git-tests/benchmarks/circuit_board/Cadence/pc042a_lib/pc042b_toplevel/images/fmc_vita57.jpg

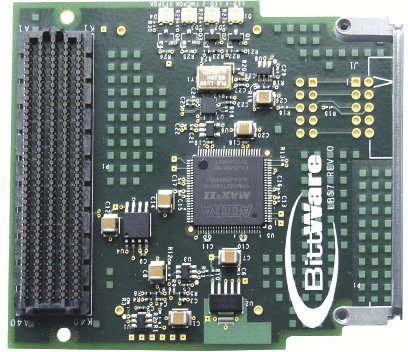
circuit_board/Cadence/pc042a_lib/pc042b_toplevel/images/fmc_vita57.jpg
