git-tests/benchmarks/circuit_board/README

AIDA mini-TLU

Double-height FMC with single FMC-LPC connector

Designed in using the Cadence 16.3 package licenced through Europractice.

Uses the CERN component libraries.
