git-tests/benchmarks/circuit_board/Cadence/pc042a_lib/pc036a_fmc_lpc_connector/metadata/pinlist.txt

(Pinlist
	(Pin
		(Name IIC_SDA_MAIN)
		(MSB )
		(LSB )
		(Type UNSPEC)
		(Location Top)
		(InputLoadLow )
		(InputLoadHigh )
		(OutputLoadLow )
		(OutputLoadHigh )
		(CheckLoad Off)
		(CheckIO Off)
		(CheckDir 0)
		(CheckAssert 0)
		(CheckOutput 0)
		(UnknownLoading 0)
		(PinShape Line)
		(DIFF_PAIR_PINS_POS )
		(DIFF_PAIR_PINS_NEG )
	)

	(Pin
		(Name FMC_LA*)
		(MSB 33)
		(LSB 0)
		(Type UNSPEC)
		(Location Top)
		(InputLoadLow )
		(InputLoadHigh )
		(OutputLoadLow )
		(OutputLoadHigh )
		(CheckLoad Off)
		(CheckIO Off)
		(CheckDir 0)
		(CheckAssert 0)
		(CheckOutput 0)
		(UnknownLoading 0)
		(PinShape Dot)
		(DIFF_PAIR_PINS_POS )
		(DIFF_PAIR_PINS_NEG )
	)

	(Pin
		(Name FMC_LA)
		(MSB 33)
		(LSB 0)
		(Type UNSPEC)
		(Location Top)
		(InputLoadLow )
		(InputLoadHigh )
		(OutputLoadLow )
		(OutputLoadHigh )
		(CheckLoad Off)
		(CheckIO Off)
		(CheckDir 0)
		(CheckAssert 0)
		(CheckOutput 0)
		(UnknownLoading 0)
		(PinShape Line)
		(DIFF_PAIR_PINS_POS )
		(DIFF_PAIR_PINS_NEG )
	)

	(Pin
		(Name FMC_CLK1_M2C_P)
		(MSB )
		(LSB )
		(Type UNSPEC)
		(Location Top)
		(InputLoadLow )
		(InputLoadHigh )
		(OutputLoadLow )
		(OutputLoadHigh )
		(CheckLoad Off)
		(CheckIO Off)
		(CheckDir 0)
		(CheckAssert 0)
		(CheckOutput 0)
		(UnknownLoading 0)
		(PinShape Line)
		(DIFF_PAIR_PINS_POS )
		(DIFF_PAIR_PINS_NEG )
	)

	(Pin
		(Name FMC_CLK1_M2C*)
		(MSB )
		(LSB )
		(Type UNSPEC)
		(Location Top)
		(InputLoadLow )
		(InputLoadHigh )
		(OutputLoadLow )
		(OutputLoadHigh )
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
		(LSB )
		(Type UNSPEC)
		(Location Left)
		(InputLoadLow )
		(InputLoadHigh )
		(OutputLoadLow )
		(OutputLoadHigh )
		(CheckLoad Off)
		(CheckIO Off)
		(CheckDir 0)
		(CheckAssert 0)
		(CheckOutput 0)
		(UnknownLoading 0)
		(PinShape Line)
		(DIFF_PAIR_PINS_POS )
		(DIFF_PAIR_PINS_NEG )
	)

	(Pin
		(Name FPGA_TCK_BUF)
		(MSB )
		(LSB )
		(Type UNSPEC)
		(Location Left)
		(InputLoadLow )
		(InputLoadHigh )
		(OutputLoadLow )
		(OutputLoadHigh )
		(CheckLoad Off)
		(CheckIO Off)
		(CheckDir 0)
		(CheckAssert 0)
		(CheckOutput 0)
		(UnknownLoading 0)
		(PinShape Line)
		(DIFF_PAIR_PINS_POS )
		(DIFF_PAIR_PINS_NEG )
	)

)
