git-tests/benchmarks/circuit_board/Cadence/pc042a_lib/pc042a_toplevel/physical/pc042a_09.jpg

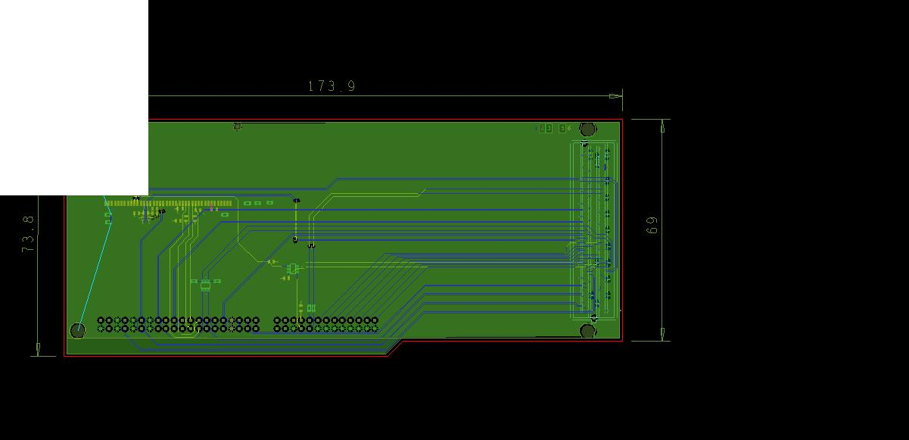
circuit_board/Cadence/pc042a_lib/pc042a_toplevel/physical/pc042a_09.jpg
