git-tests/benchmarks/circuit_board/Cadence/pc042a_lib/pc042b_vsupply5v/physical/3d.jpg

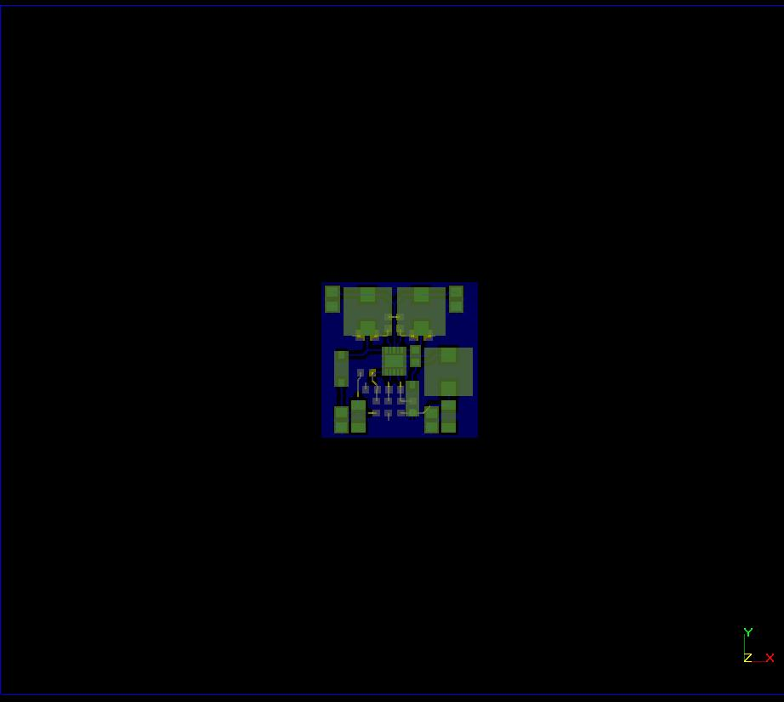
circuit_board/Cadence/pc042a_lib/pc042b_vsupply5v/physical/3d.jpg
