git-tests/benchmarks/firmware/hdl_designer/fmc_mTLU/www/images/menu/hds/hdldesigner.gif

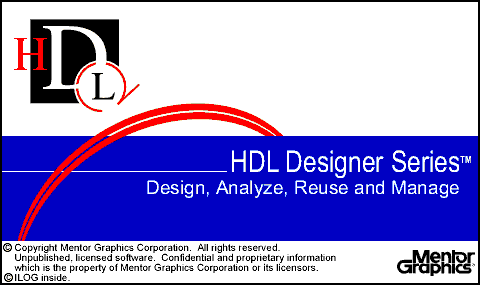
firmware/hdl_designer/fmc_mTLU/www/images/menu/hds/hdldesigner.gif
