git-tests/benchmarks/circuit_board/Cadence/worklib/fmc_tlu_toplevel/bom/fmc_mtlu.xls

TITLE: Bill of Materials
DATE: 11/01/2012
DESIGN: fmc_tlu_toplevel
TEMPLATE: G | \cad\tools\cadence_templates\spreadsheet-format.bom
CALLOUT: bom.callouts
Part Name | Ref Des | Qty | PART_NUMBER | PART_DESCRIPTION | distributor part no. | unit cost | total cost
24AA025E48 | IC7 | 1 | 24AA025E48 |  | Farnell 1814890 | £0.27 | £0.27
AD5665RBRUZ-1 | IC1 | 1 | AD5665RBRUZ-1 |  | Farnell 1498714 | £13.95 | £13.95
ASP-134606-01 | J4 | 1 | ASP-134606-01 | Samtec FMC connector. Order from Samtec | ? | 0 | £0.00
CAPCERSMDCL1_0603-33PF,50V | C6_5 | 1 | CC0603_33PF_50V_5%_NP0 |  | Farnell 1414633 | £0.02 | £0.02
CAPCERSMDCL1_0603-68PF,50V | C9_5 | 1 | CC0603_68PF_50V_5%_NP0 |  | Farnell 1414647 | £0.03 | £0.03
CAPCERSMDCL2_0603-1.0UF,6.3V | C3_1,C3_2,C3_3,C3_4,C4_1,C4_2,C4_3,C4_4,C6_1,C6_2,C6_3,C6_4 | 12 | CC0603_1UF_6V3_10%_X5R |  | Farnell 1327676 | £0.08 | £1.01
CAPCERSMDCL2_0603-100NF,16V | C1,C1_1,C1_2,C1_3,C1_4,C4,C4_5,C5,C5_1,C5_2,C5_3,C5_4,C7,C7_1,C7_2,C7_3,C7_4,C8,C8_1,C8_2,C8_3,C8_4,C9,C9_1,C9_2,C9_3,C9_4,C10,C10_1,C10_2,C10_3,C10_4,C11,C12,C13,C14,C15,C16,C17 | 39 | CC0603_100NF_16V_10%_X7R | ? | Farnell 1301716 | £0.09 | £3.39
CAPCERSMDCL2_0603-10NF,50V | C2_1,C2_2,C2_3,C2_4 | 4 | CC0603_10NF_50V_10%_X7R | ? | Farnell 7569548 | £0.09 | £0.36
CAPCERSMDCL2_0603-1UF,16V | C2,C3,C5_5,C6 | 4 | CC0603_1UF_16V_10%_X5R | ? | Farnell 1327680 | £0.07 | £0.30
CAPCERSMDCL2_0805-10UF,10V_GEN | C7_5 | 1 | CC0805_10UF_10V_10%_X5R | ? | Farnell 1833812 | £0.08 | £0.08
CAPCERSMDCL2_0805-330NF,50V | C2_5,C3_5 | 2 | CC0805_330NF_50V_10%_X7R | ? | Farnell 2070476 | £0.09 | £0.19
CAPCERSMDCL2_0805-4.7UF,10V | C1_5,C8_5,C10_5,C11_5,C12_5,C13_5,C14_5,C15_5 | 8 | GRM21BF51A475ZA01 | ? | Farnell 1828924 | £0.15 | £1.19
CON8P-MOLEX_44661-1011 | J3 | 1 | 44661-1011 | ? | Digikey 0446611011-ND | £3.40 | £3.40
DIODE_SCHOTTKY_CA-SD101AW | D1_5,D2_5 | 2 | SD101AW | ? | Farnell 1773493 | 0.38 | £0.76
FERRITE_SMD-7427921,WURTH | L4_5,L5_5 | 2 | 7427921 | ? | Farnell 1635739 | £0.20 | £0.40
FERRITE_SMD-BLM41P800S,MURATA | L6_5 | 1 | 08.11.BLM41P800S | ? | Digikey 490-1059-1-ND | 0.028 | £0.03
GL2L5LS050D-C | IC1_1,IC1_2,IC1_3,IC1_4 | 4 | GL2L5LS050D-C | DELAY LINE 0.5NS +-50PS 16SOIC | Digikey 408-1139-ND | 15.69 | £62.76 | Bother – expensive and difficult to get hold of
GL2L5LS100D-C | IC3_1,IC3_2,IC3_3,IC3_4 | 4 | GL2L5LS100D-C | DELAY LINE 1.0NS +-50PS 16SOIC | Digikey 408-1140-ND | 15.69 | £62.76 | expensive and difficult to get hold of.
HBAT-540C | D1_1,D1_2,D1_3,D1_4 | 4 | HBAT-540C | Schottky diode clamp | RS 752-7852 | 0.044 | £0.18 | Substitute BAT 64-04 for HBAT-540C
INDUCTANCE_XS-10UH_25% | L1_5,L2_5,L3_5 | 3 | 744778510 | ? | Farnell 1635961 | £1.65 | £4.95
LT1129CST-5_SOT223-LINEAR | VR1_5 | 1 | Linear Technology LT1129CST-5 | 700mA, 5V LDO Regulator | Farnell 1663375 | £3.38 | £3.38
LT1175_SOT_223 | REG1_5 | 1 | Farnell | 500mA Negative low dropout Micropower Regulator | Farnell 1663390 | £3.88 | £3.88
LT3471EDD#PBF | IC1_5 | 1 | LT3471EDD#PBF | ? | Farnell 1663557 | £5.09 | £5.09
MAX9601_TSSOP | IC2_1,IC2_2,IC2_3,IC2_4 | 4 | MAX9601EUP | ? | Farnell 1610136 | £10.19 | £40.76
MHDMI-19-02-H-TH-L-TR | J1,J2 | 2 | MHDMI-19-02-H-TH-L-TR | ? | RS 720-6003 | £0.92 | £1.84
OPA4277UA | IC2 | 1 | OPA4277UA | ? | Farnell 1097479 | £8.14 | £8.14
PCOAX-PLEMO00C | PX2,PX3,PX4,PX5 | 4 | EPL.00.250.NTN | ? | farnel/cpc CN08069 | £7.56 | £30.24
PLEMO2CI-PLEMO2-00B | PX1 | 1 | EPG.00.302.NLN | ? | RS 204-8824 | £31.18 | £31.18
PRTR5V0U8S_TSSOP-NXP | U1,U2,U3 | 3 | PRTR5V0U8S | ESD Protection Diodes 5.5V Octal TSSOP10 | RS 725-8739 , Farnell 1757871 | £0.69 | £2.07
RSMD0402_1/16W-51,1% | R1_1,R1_2,R1_3,R1_4,R4_1,R4_2,R4_3,R4_4 | 8 | R0402_51R_1%_0.063W_200PPM | ? | Farnell 1458803 | £0.06 | £0.51
RSMD0603_-00, | R18,R20,R22 | 3 | R0603_00_JUMPER | ? | Farnell 9233130 | £0.06 | £0.18
RSMD0603_1/10W-100,1% | R5_1,R5_2,R5_3,R5_4,R7_1,R7_2,R7_3,R7_4 | 8 | R0603_100R_1%_0.1W_100PPM | ? | Farnell 2008332 | £0.01 | £0.12
RSMD0603_1/10W-10K,1% | R1,R2,R3,R4,R5,R6,R7,R8 | 8 | R0603_10K_1%_0.1W_100PPM | ? | Farnell 2008341 | £0.01 | £0.12
RSMD0603_1/10W-1K,1% | R15,R16 | 2 | R0603_1K_1%_0.1W_100PPM | ? | Farnell 1688459 | £0.88 | £1.76
RSMD0603_1/10W-33K,1% | R9_1,R9_2,R9_3,R9_4 | 4 | R0603_33K_1%_0.1W_100PPM | ? | Farnell 2008364 | £0.01 | £0.04
RSMD0603_1/10W-51,1% | R3_1,R3_2,R3_3,R3_4,R9,R10,R11,R12,R13,R14 | 10 | R0603_51R_1%_0.1W_100PPM | ? | Farnell 2059275 | £0.01 | £0.09
RSMD0603_1/10W-75,1% | R11_1,R11_2,R11_3,R11_4,R12_1,R12_2,R12_3,R12_4,R13_1,R13_2,R13_3,R13_4,R14_1,R14_2,R14_3,R14_4 | 16 | R0603_75R_1%_0.1W_100PPM | ? | Farnell 2059282 | £0.01 | £0.14
RSMD0603_1/10W-XX,1% | R10_1,R10_2,R10_3,R10_4,R17,R19,R21 | 7 | R0603_XX_1%_0.1W_100PPM | ? | not fitted | 0 | £0.00
RSMD0603_1/16W-20K,1% | R3_5,R6_5 | 2 | R0603_20K_1%_0.063W_100PPM | ? | Farnell 2059432 | £0.01 | £0.02
RSMD0603_1/16W-4.7K,5% | R1_5,R2_5 | 2 | R0603_4K7_5%_0.063W_100PPM | ? | Farnell 1632579 | £0.02 | £0.05
RSMD0603_1/16W-90.9K,1% | R5_5 | 1 | R0603_90K9_1%_0.063W_100PPM | ? | Farnell 2059492 | £0.01 | £0.01
RSMD0603_100MW-110K,0.1% | R4_5 | 1 | R0603_110K_0.1%_0.100W_100PPM | ? | Farnell 2059495 | £0.01 | £0.01
RSMD0805_125MW-100,1% | R6_1,R6_2,R6_3,R6_4,R8_1,R8_2,R8_3,R8_4 | 8 | R0805_100R_1%_0.125W_100PPM | ? | Farnell 1469862 | £0.01 | £0.11
RSMD0805_125MW-12,1% | R2_1,R2_2,R2_3,R2_4 | 4 | R0805_12R_1%_0.125W_100PPM | ? | Farnell 1260836 | £0.01 | £0.04
SN74LVC1G07DCK | IC4,IC6 | 2 | SN74LVC1G07DCK | ? | Farnell 1236609 | £0.28 | £0.56
TRANS MOSFET_GSD-FDV301N,SOT23 | T1,T2 | 2 | FDV301N | ? | farnel/cpc SC11006 | £0.07 | £0.14
USBLC6-2SC6 | IC3,IC5 | 2 | USBLC6-2SC6 | ? | Farnell 1269406 | £0.53 | £1.06
TOTAL |  | 204
Different types of component |  | 47 |  |  |  | Grand total | £287.56
 | Note:- resistors are bought in packs of fifty so the price will be slightly higher |  |  |  |  | Grand total (no delay lines) | £162.05
