git-tests/benchmarks/circuit_board/Manufacturing/checklists/fmc_tlu_toplevel_v1_schematic_checklist.xls

Item | Comments | Result | Checked by | Date checked
IC7 connected correctly? | Not that important – only present to allow each board to have a unique ID
J1,J2,J3 connected correctly? | ESSENTIAL: J3 should be like EUDET TLU, J1,J2 should be compatible with CALICE C&C board https://twiki.cern.ch/twiki/pub/CALICE/ClockControlCard/CCC_sch_1aa_2008-08-29.pdf
IC3, U1 etc. Connected correctly? | Protection diodes. Could be omitted if pinout incorrect
IC4, T1 etc. Connected correctly | Switchable power on HDMI for HDMI-->Lemo converter boards. Could be patched if required
J4 connected correctly? | Very important – but already checked pretty thoroughly
IC1 connected correctly? | Very important – could hack board to apply biases from external supply, but pretty nasty
IC2 connected correctly? | Very important – but believed correct
IC2_1 ... IC2_4 connected correctly? | ESSENTIAL: this circuit is simple, but hasn't been constructed by me before.
IC1_5 , VR1_5 , REG1_5 connected correctly? | VERY IMPORTANT – could hack board to supply +/-5V externally, but pretty nasty
LT3471 , MAX9601 footprints correct? | Not used before
