git-tests/benchmarks/circuit_board/Schematics/fmc_tlu_cfd.pdf

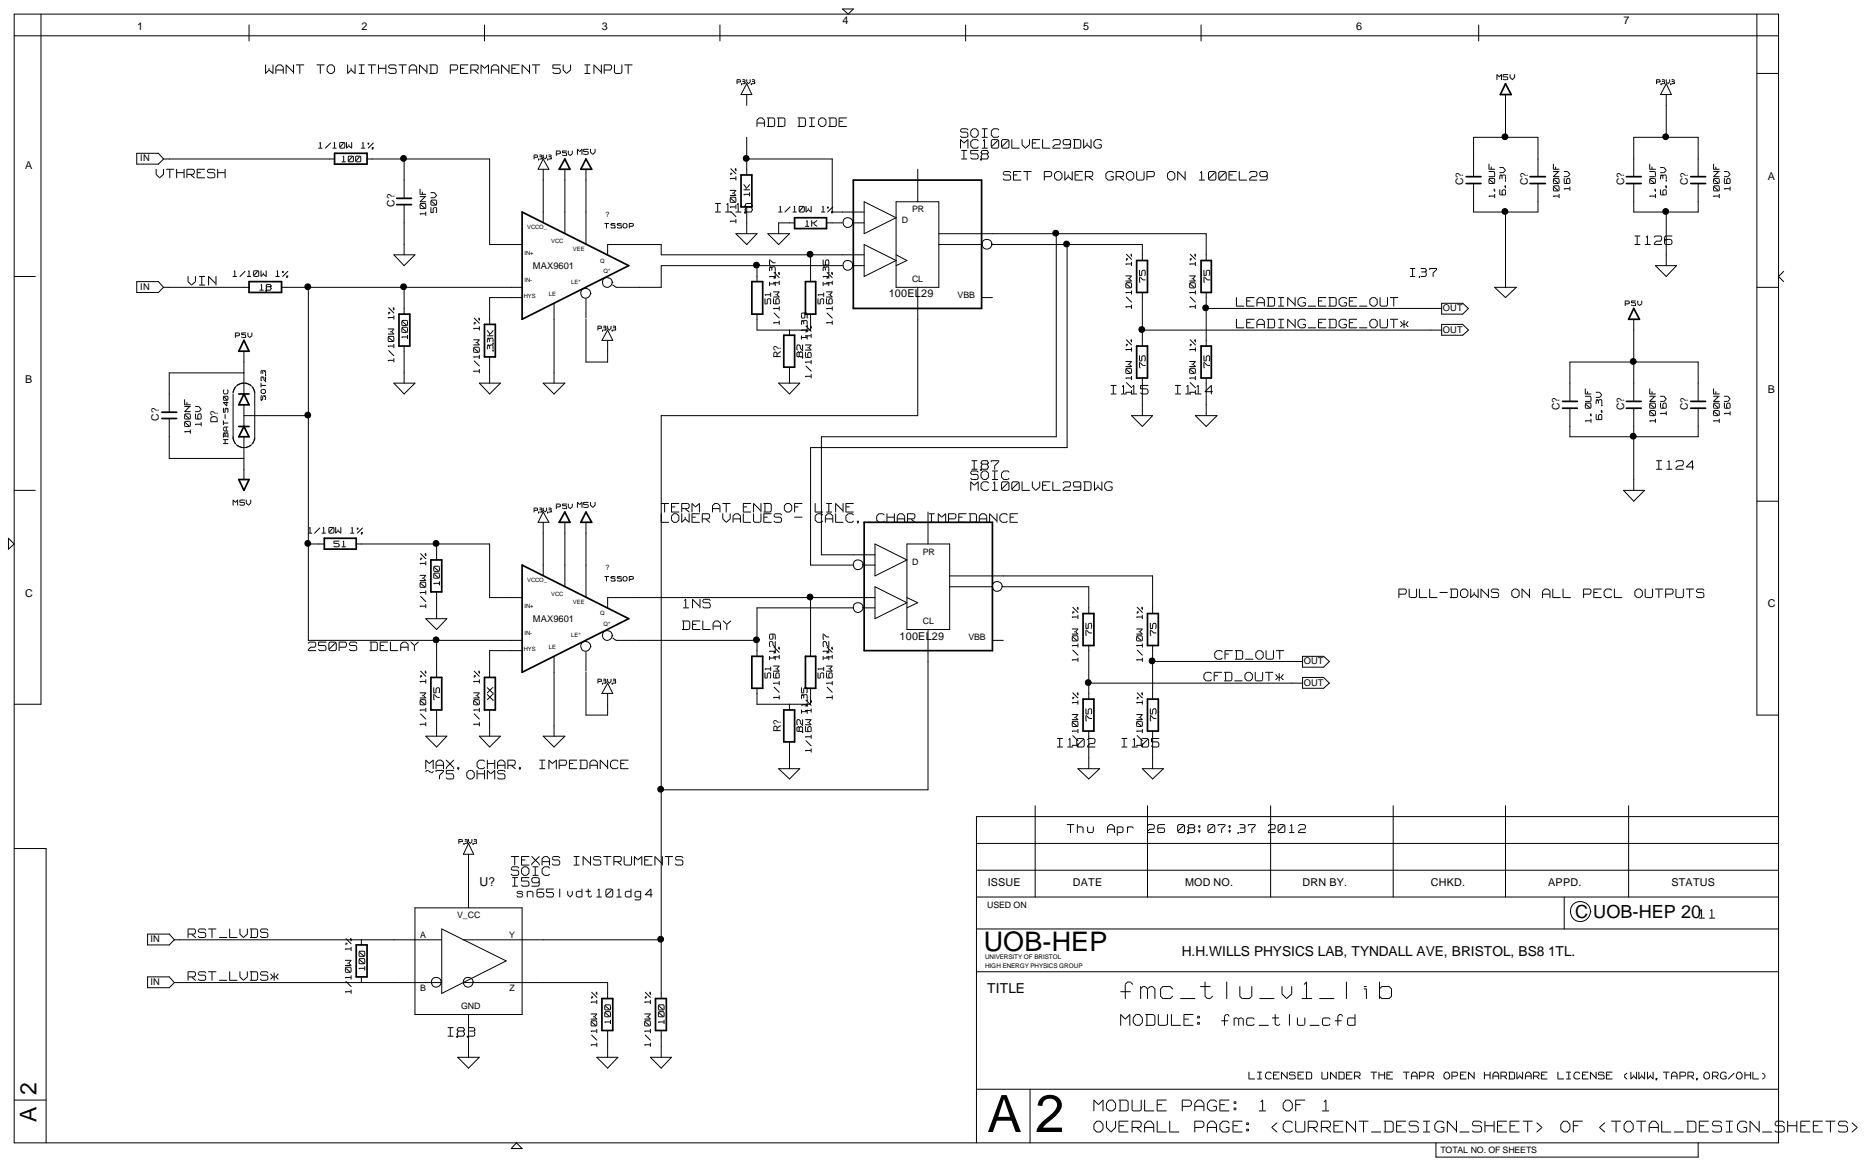
[picture p7: page 1]
DELAY; ADD DIODE; 250PS DELAY; LOWER VALUES - CALC. CHAR; IMPEDANCE; MODULE; PAGE: 1 OF 1; OVERALL; PAGE: <CURRENT_DESIGN_SHEET>; OF <TOTAL_DESIGN_SHEETS>; Thu Apr 26 08:07:37 2012; I87 MC100LVEL29DWG SOIC; TSSOP; LEADING_EDGE_OUT*; LEADING_EDGE_OUT; RST_LVDS*; sn65lvdt101dg4; I59 SOIC; RST_LVDS; TEXAS INSTRUMENTS; SOT23; HBAT-540C; CFD_OUT*; 1/10W CFD_OUT; 1% VIN; VTHRESH; VCCO_; VEE; VCC; HYS; VBB; GND; MAX9601; OUT; UOB-HEP

WANT TO WITHSTAND PERMANENT 5V INPUT

SOIC
I58 MC100LVEL29DWG
SET POWER GROUP ON 100EL29

TERM AT END OF LINE

PULL-DOWNS ON ALL PECL OUTPUTS

~75 OHMS MAX. CHAR. IMPEDANCE

ISSUE | DATE | MOD NO. | DRN BY. | CHKD. | APPD. | STATUS
USED ON | C UOB-HEP 20 11

UNIVERSITY OF BRISTOL
HIGH ENERGY PHYSICS GROUP
TITLE

H.H.WILLS PHYSICS LAB, TYNDALL AVE, BRISTOL, BS8 1TL.
fmc_tlu_v1_lib
MODULE: fmc_tlu_cfd

LICENSED UNDER THE TAPR OPEN HARDWARE LICENSE (WWW.TAPR.ORG/OHL)

TOTAL NO. OF SHEETS
