git-tests/benchmarks/circuit_board/Schematics/fmc_tlu_v1.pdf

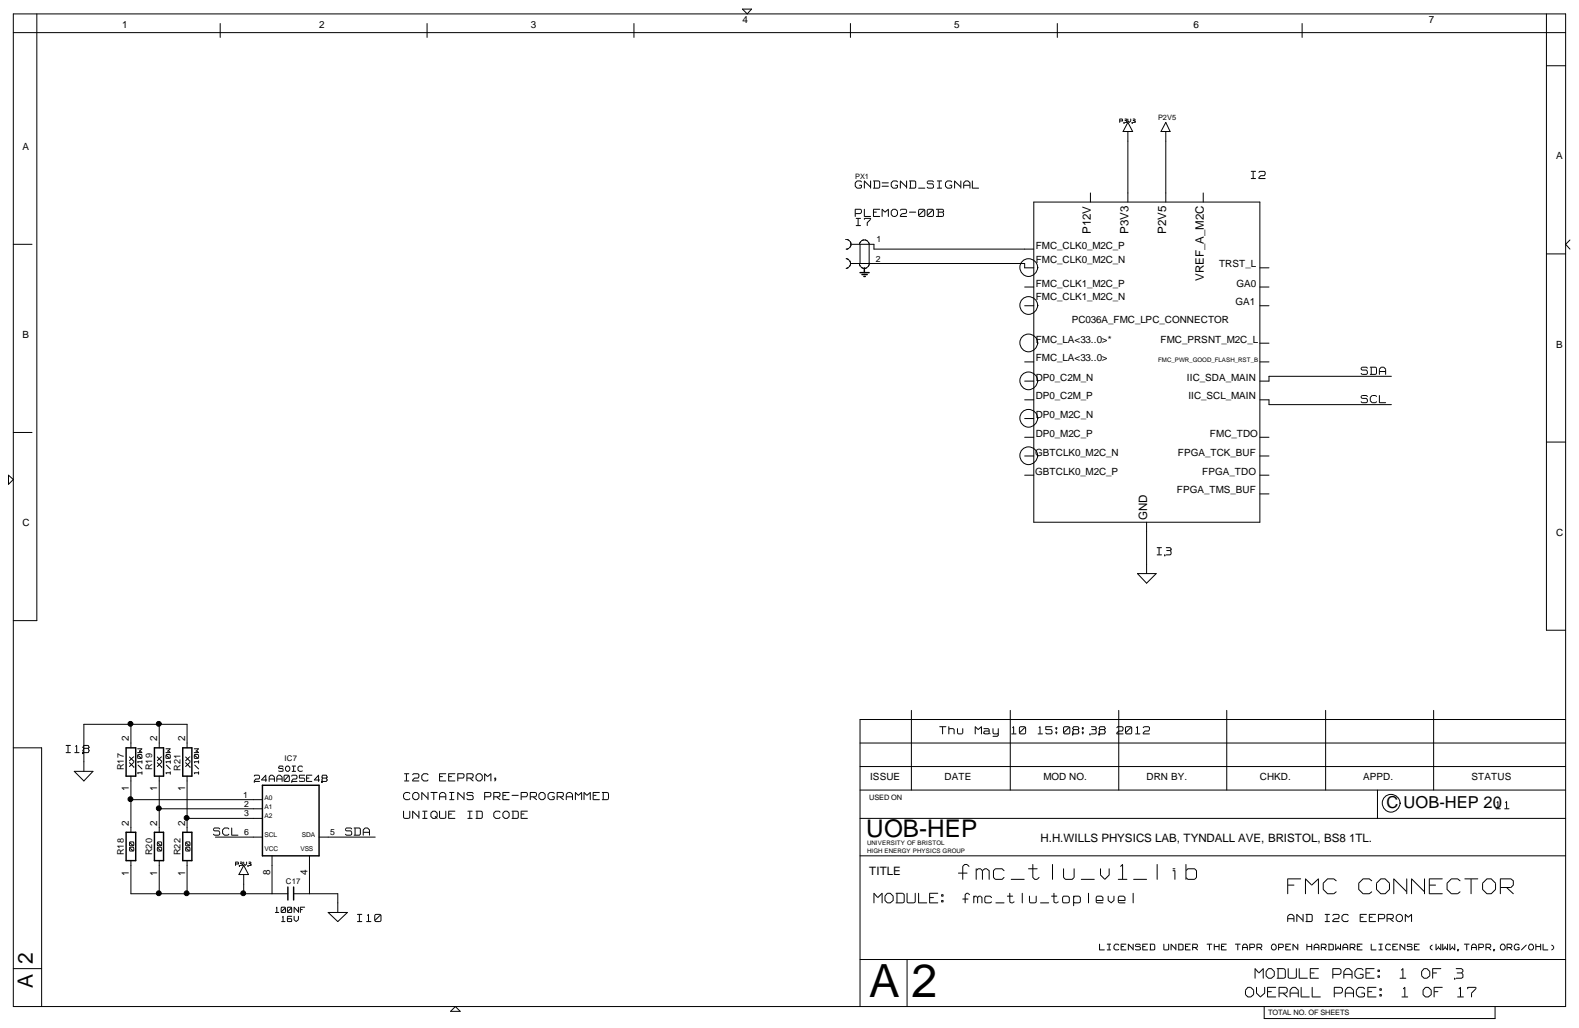
[picture p8: page 1]

UNIVERSITY OF BRISTOL
HIGH ENERGY PHYSICS GROUP

H.H.WILLS PHYSICS LAB, TYNDALL AVE, BRISTOL, BS8 1TL.

LICENSED UNDER THE TAPR OPEN HARDWARE LICENSE (WWW.TAPR.ORG/OHL)

TOTAL NO. OF SHEETS

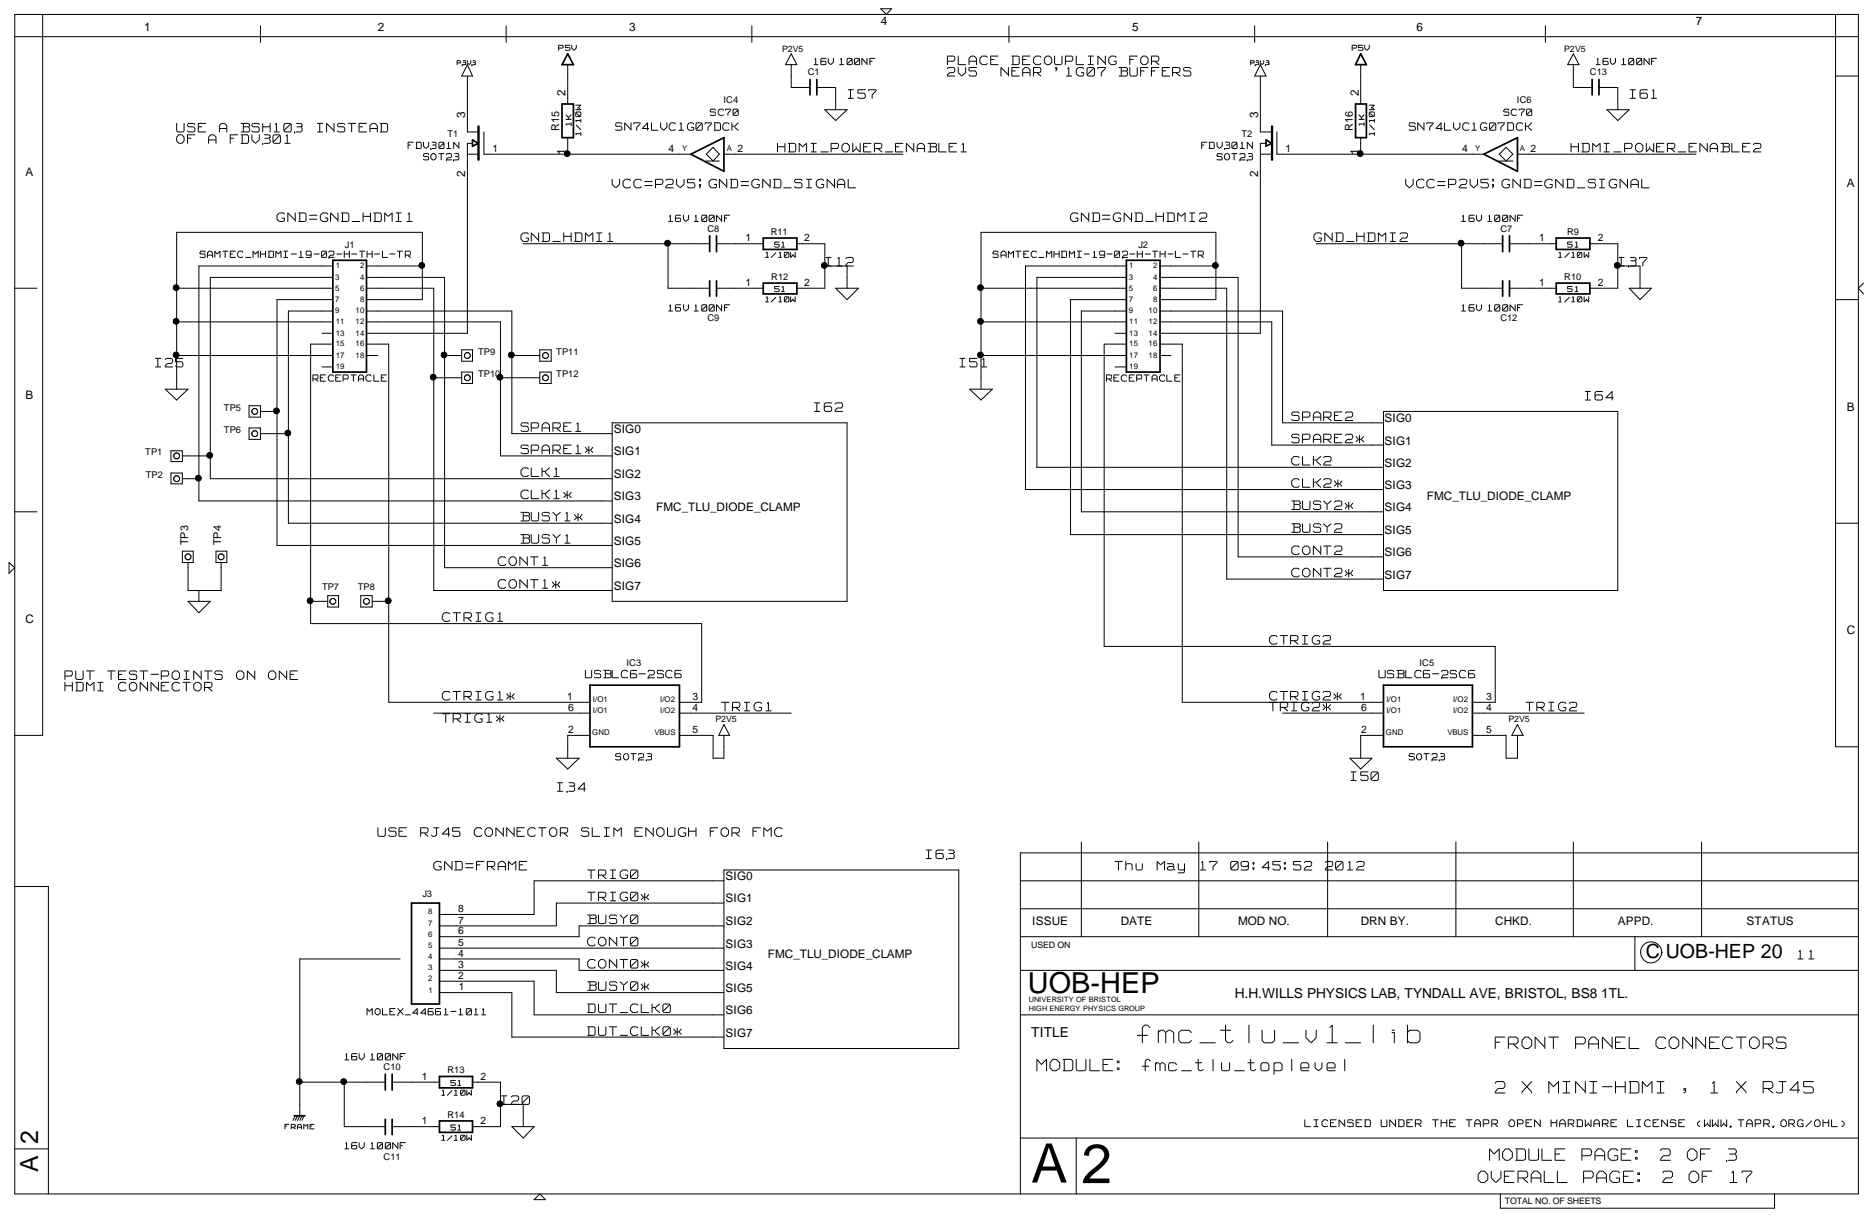
[picture p9: page 2]

PUT TEST-POINTS ON ONE
HDMI CONNECTOR

USE RJ45 CONNECTOR SLIM ENOUGH FOR FMC

UNIVERSITY OF BRISTOL
HIGH ENERGY PHYSICS GROUP
TITLE
MODULE: fmc_tlu_toplevel

H.H.WILLS PHYSICS LAB, TYNDALL AVE, BRISTOL, BS8 1TL.

LICENSED UNDER THE TAPR OPEN HARDWARE LICENSE (WWW.TAPR.ORG/OHL)

TOTAL NO. OF SHEETS

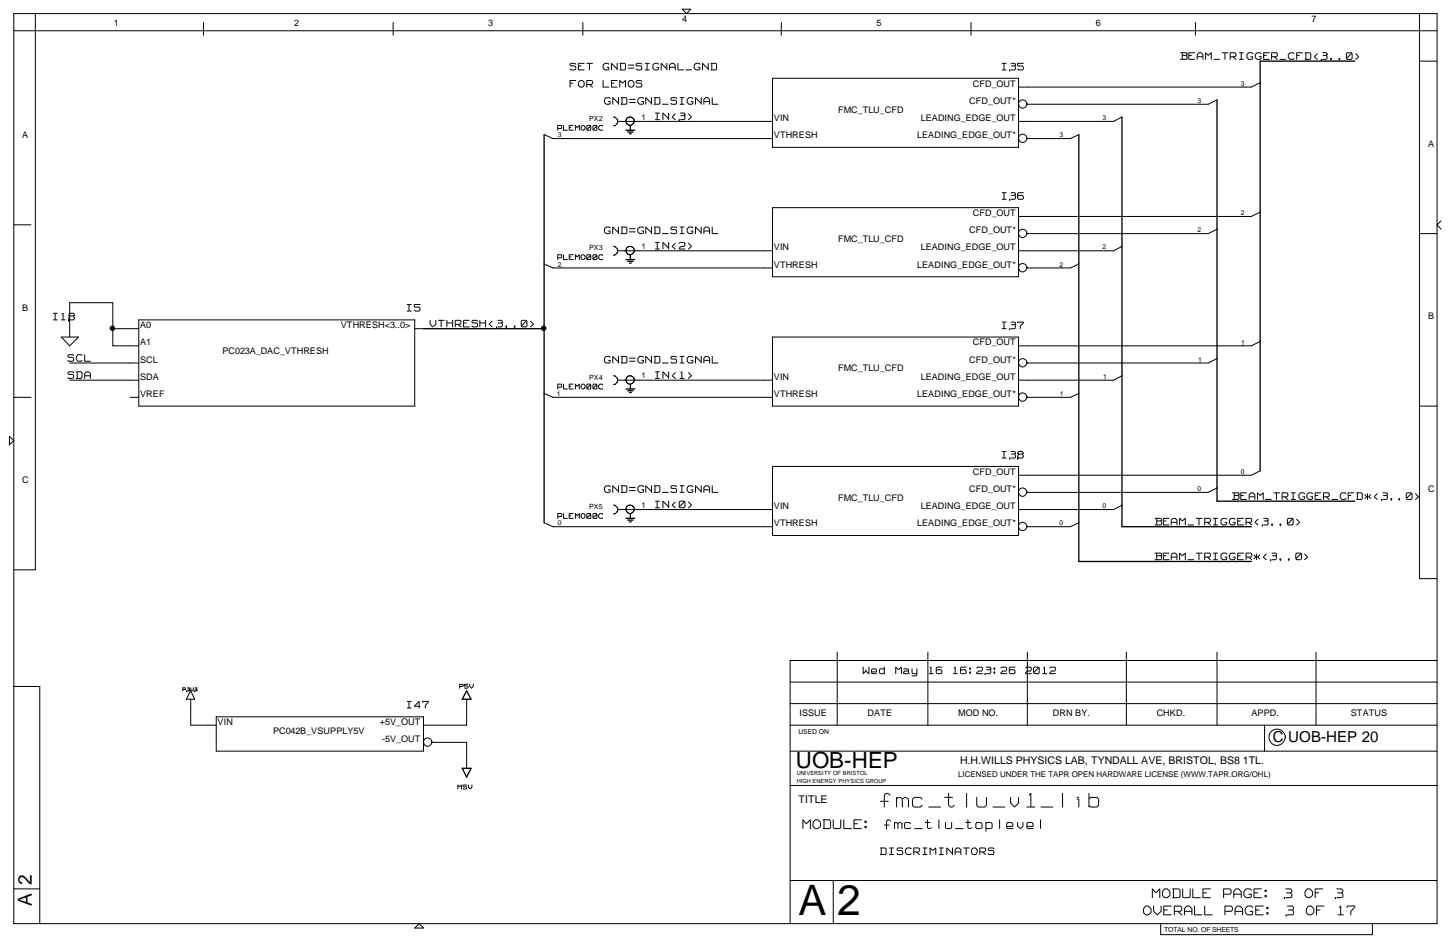
[picture p10: page 3]
DISCRIMINATORS; SET GND=SIGNAL_GND FOR LEMOS; OVERALL; PAGE: 3 OF 17; Wed May 16 16:23:26 2012; fmc_tlu_v1_lib; MODULE; PAGE: 3 OF 3; SCL SDA; BEAM_TRIGGER<3..0>; BEAM_TRIGGER*<3..0>; BEAM_TRIGGER_CFD<3..0>; BEAM_TRIGGER_CFD*<3..0>; PLEMO00C; VTHRESH<3..0>; GND=GND_SIGNAL; PC023A_DAC_VTHRESH; VREF; SDA; SCL; PC042B_VSUPPLY5V; VIN; +5V_OUT; -5V_OUT; FMC_TLU_CFD; VTHRESH; CFD_OUT; CFD_OUT*; LEADING_EDGE_OUT; LEADING_EDGE_OUT*; UOB-HEP

ISSUE | DATE | MOD NO. | DRN BY. | CHKD. | APPD. | STATUS

USED ON | C UOB-HEP 20

H.H.WILLS PHYSICS LAB, TYNDALL AVE, BRISTOL, BS8 1TL.
LICENSED UNDER THE TAPR OPEN HARDWARE LICENSE (WWW.TAPR.ORG/OHL)

UNIVERSITY OF BRISTOL
HIGH ENERGY PHYSICS GROUP
TITLE
MODULE: fmc_tlu_toplevel

TOTAL NO. OF SHEETS

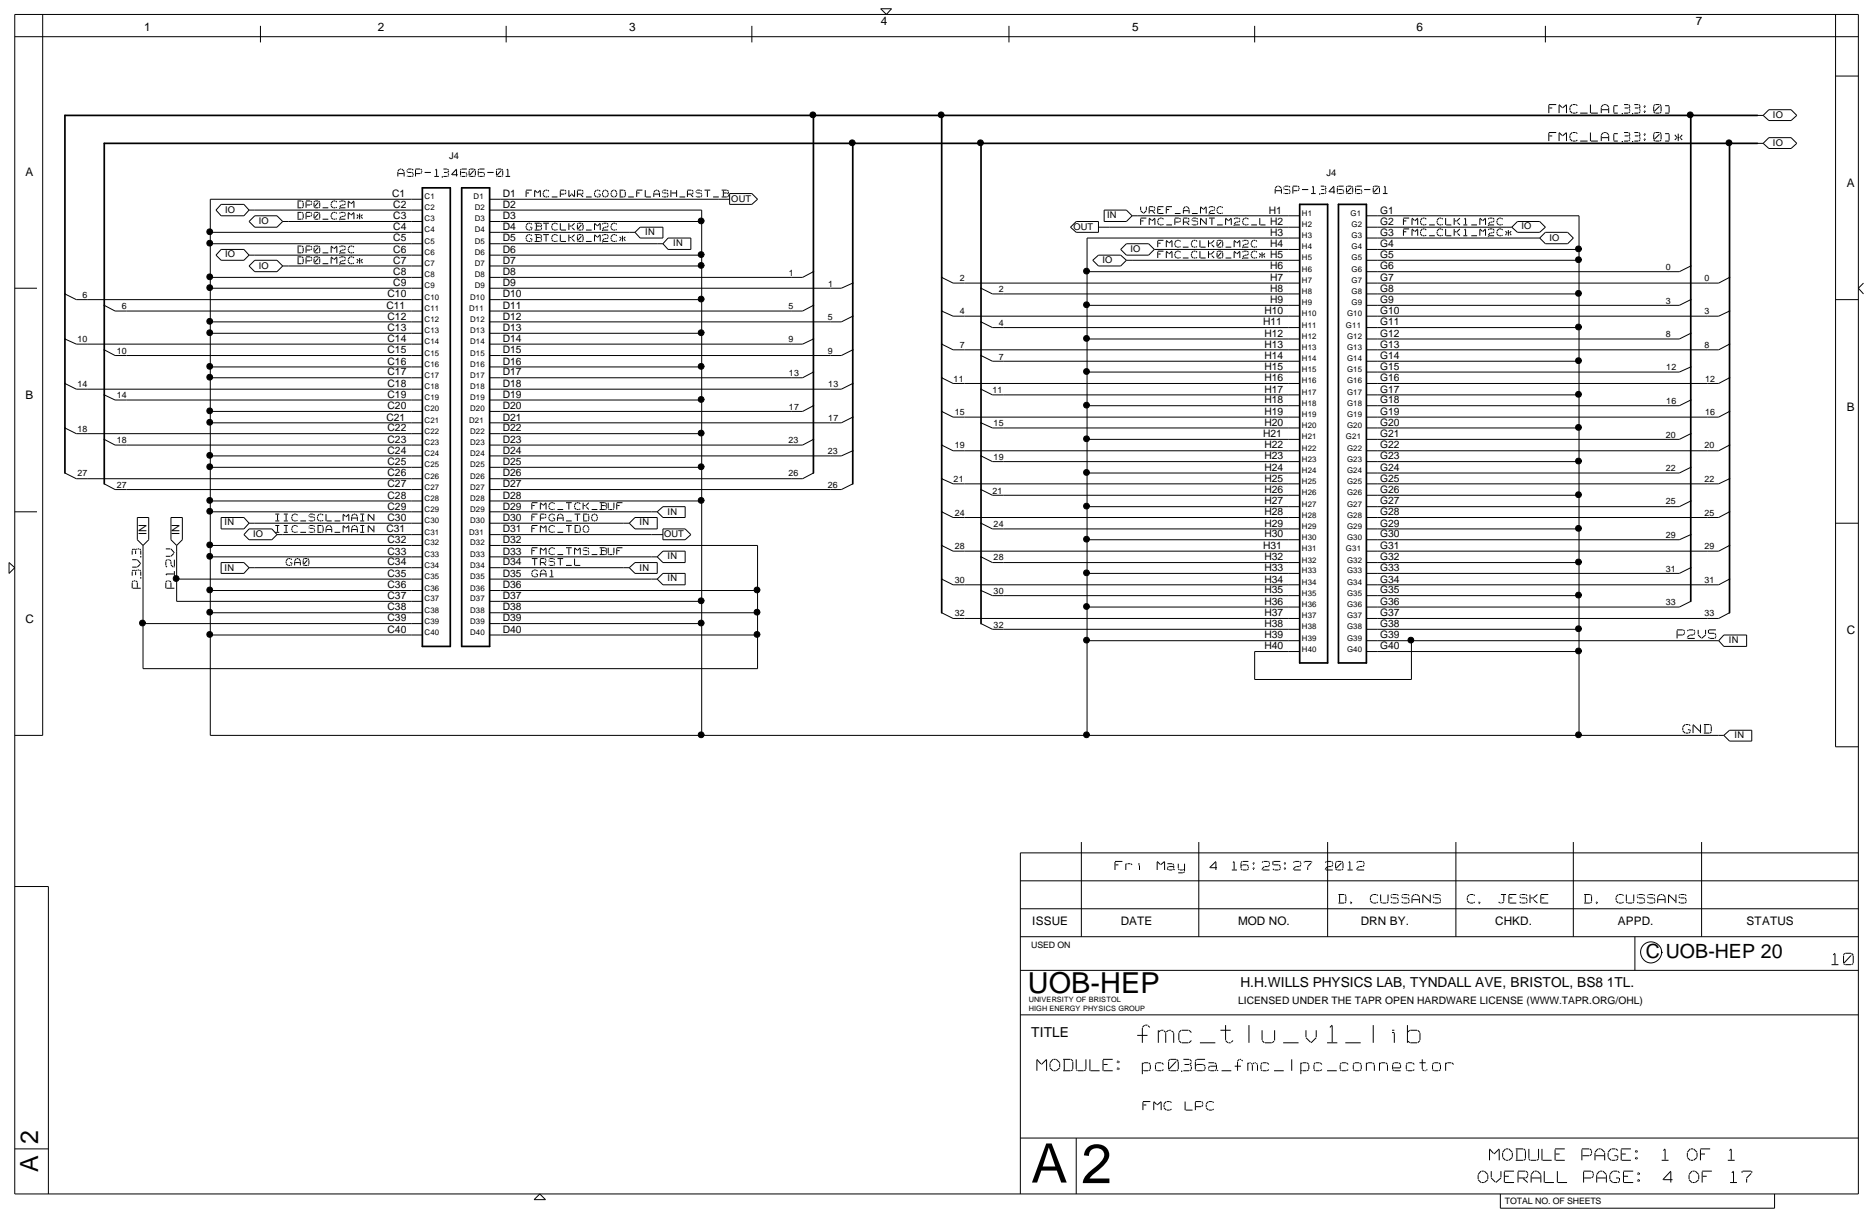
[picture p11: page 4]

A | FMC_LA[33:0]

FMC_LA[33:0]*

IN C34 | IN D34 TRST_L IN D35 GA1

C36 | | D36
C37 | | D37
C39 | | D39
C40 | | D40

Fri May | 4 16:25:27 2012

D. CUSSANS | C. JESKE | D. CUSSANS

ISSUE | DATE | MOD NO. | DRN BY. | CHKD. | APPD. | STATUS

USED ON | C UOB-HEP 20

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

UNIVERSITY OF BRISTOL
HIGH ENERGY PHYSICS GROUP
TITLE

TOTAL NO. OF SHEETS

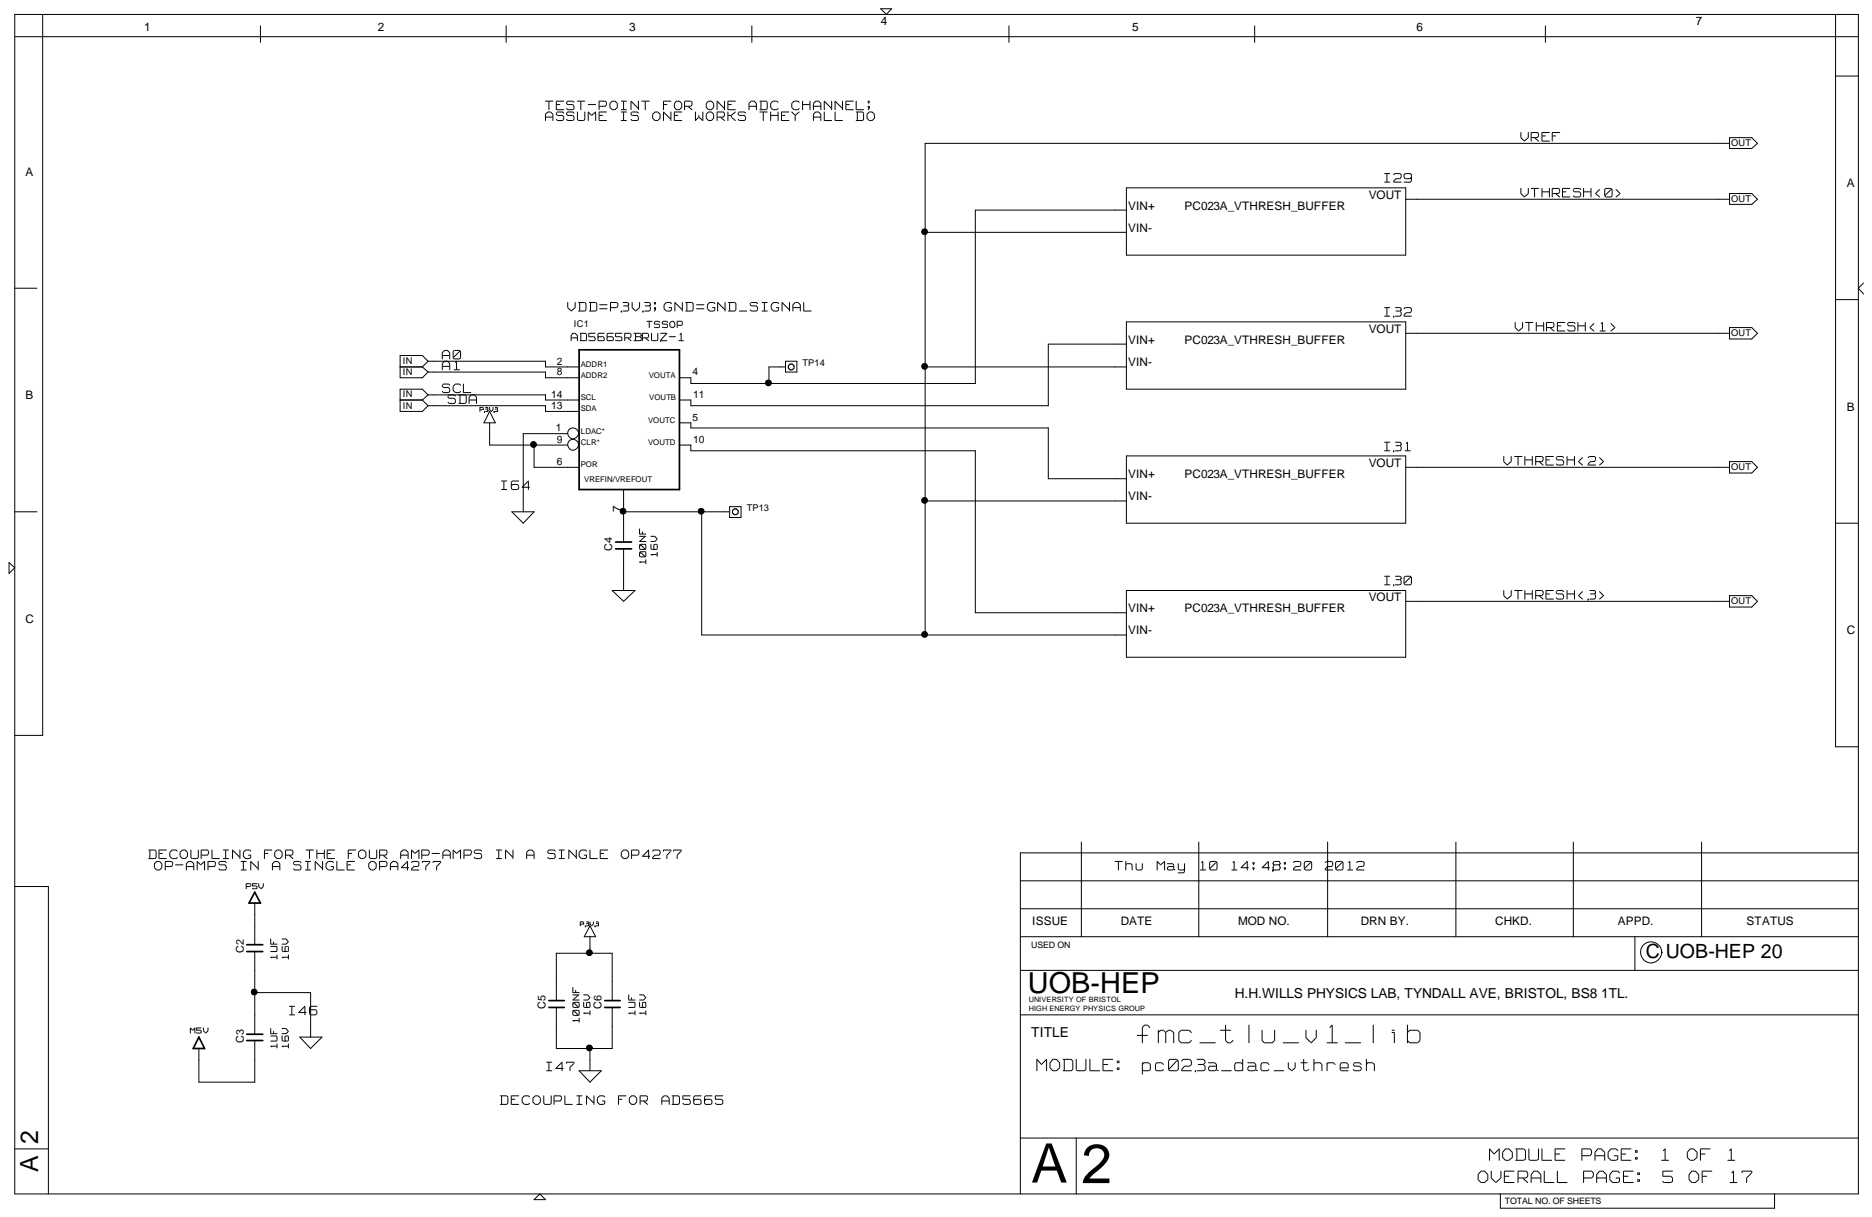
[picture p12: page 5]

TEST-POINT FOR ONE ADC CHANNEL;
ASSUME IS ONE WORKS THEY ALL DO

DECOUPLING FOR THE FOUR AMP-AMPS IN A SINGLE OP4277
OP-AMPS IN A SINGLE OPA4277

ISSUE | DATE | MOD NO. | DRN BY. | CHKD. | APPD. | STATUS

USED ON | C UOB-HEP 20

UNIVERSITY OF BRISTOL
HIGH ENERGY PHYSICS GROUP
TITLE

H.H.WILLS PHYSICS LAB, TYNDALL AVE, BRISTOL, BS8 1TL.

TOTAL NO. OF SHEETS

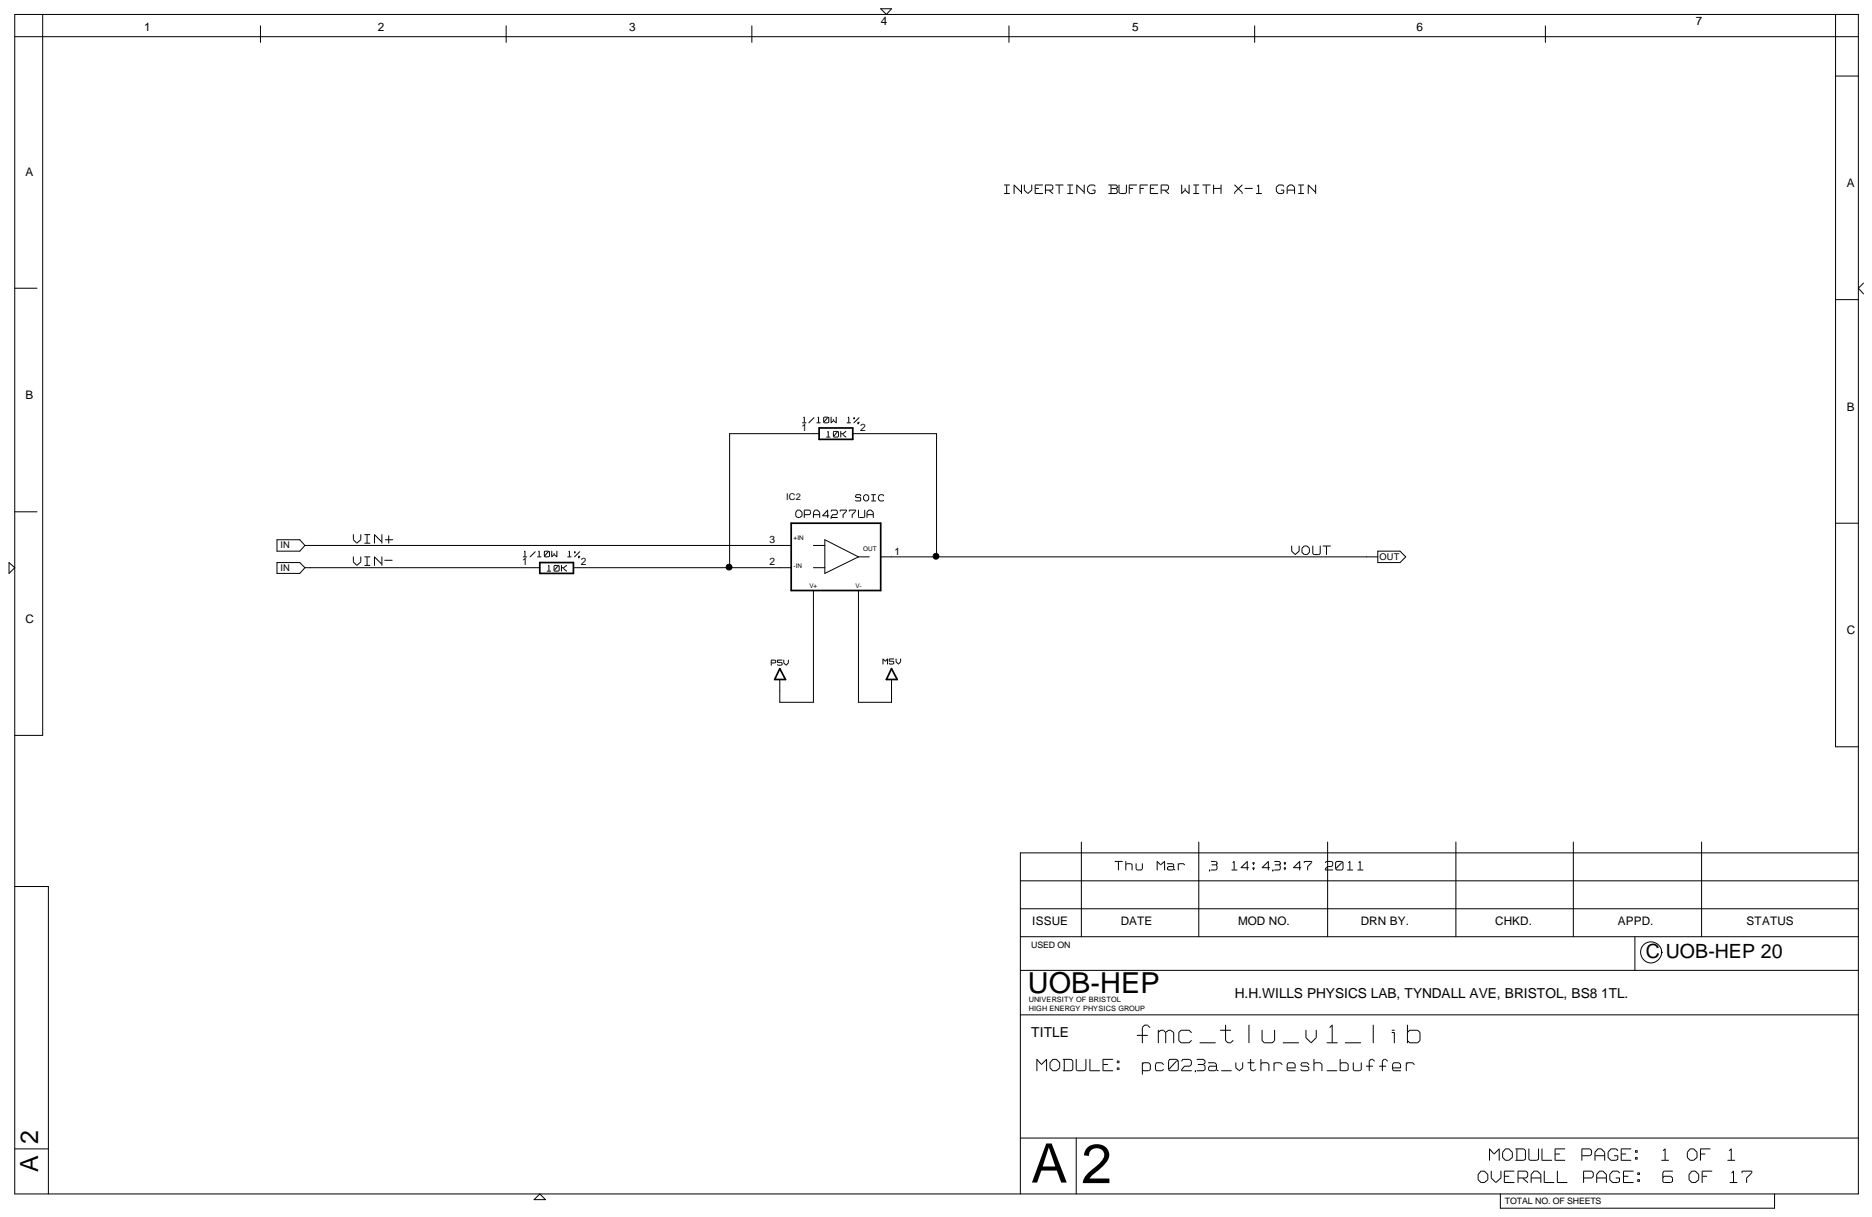
[picture p13: page 6]
Thu Mar; OVERALL; PAGE: 6 OF 17; MODULE; PAGE: 1 OF 1; fmc_tlu_v1_lib; MODULE:; pc023a_vthresh_buffer; VOUT; VIN+; OPA4277UA; 10K VIN-; OUT; UOB-HEP

INVERTING BUFFER WITH X-1 GAIN

IC2 | 10K | SOIC

ISSUE | DATE | MOD NO. | DRN BY. | CHKD. | APPD. | STATUS

USED ON | C UOB-HEP 20

UNIVERSITY OF BRISTOL
HIGH ENERGY PHYSICS GROUP
TITLE

H.H.WILLS PHYSICS LAB, TYNDALL AVE, BRISTOL, BS8 1TL.

TOTAL NO. OF SHEETS

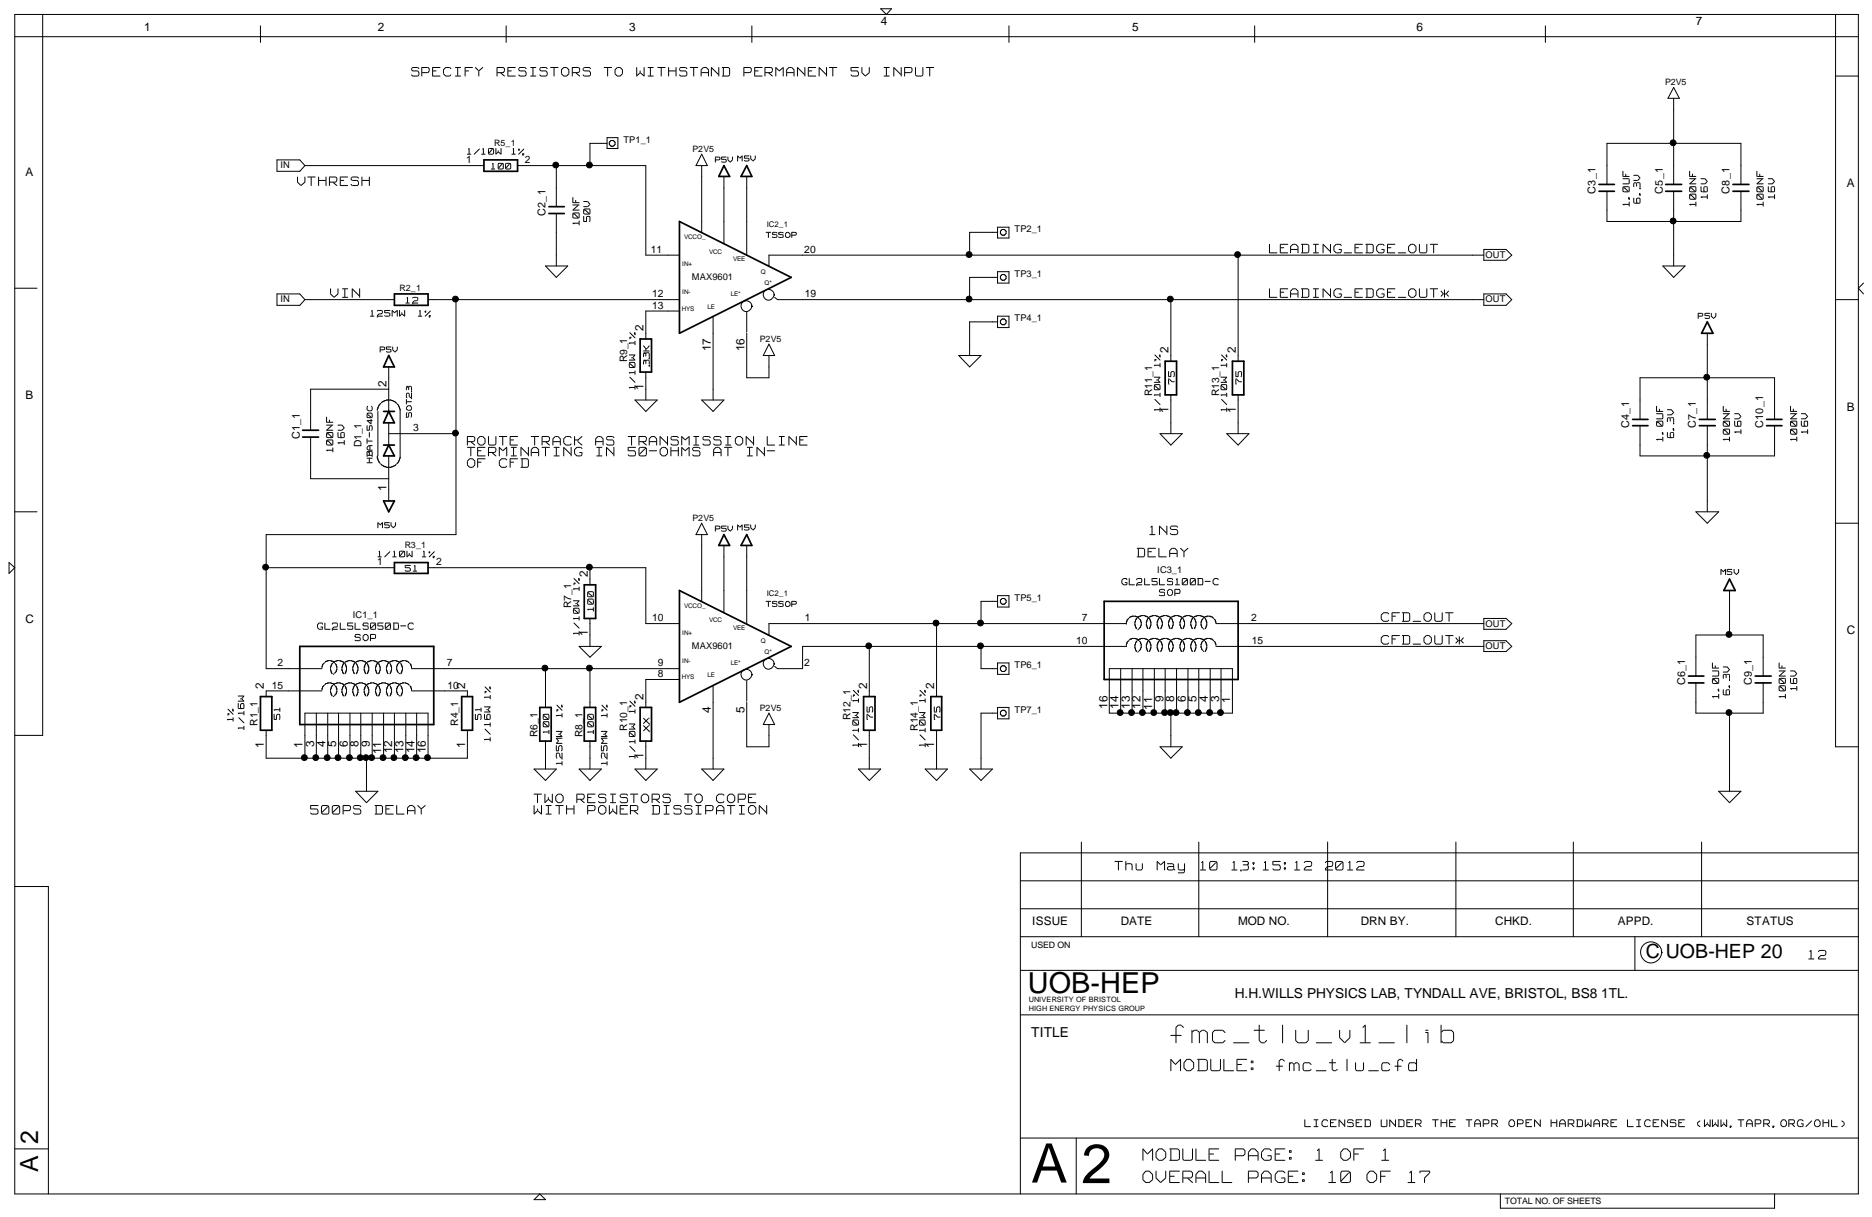
[picture p14: page 7]
500PS DELAY; DELAY; Thu May 10 13:15:12 2012; MODULE; PAGE: 1 OF 1; OVERALL; PAGE: 10 OF 17; CFD_OUT CFD_OUT*; GL2L5LS100D-C SOP; VTHRESH; GL2L5LS050D-C SOP; SOT23; HBAT-540C; TSSOP; VIN; LEADING_EDGE_OUT; LEADING_EDGE_OUT*; VCCO_; VEE; VCC; HYS; MAX9601; OUT; UOB-HEP

SPECIFY RESISTORS TO WITHSTAND PERMANENT 5V INPUT

ROUTE TRACK AS TRANSMISSION LINE
TERMINATING IN 50-OHMS AT IN-
OF CFD

TWO RESISTORS TO COPE
WITH POWER DISSIPATION

ISSUE | DATE | MOD NO. | DRN BY. | CHKD. | APPD. | STATUS
USED ON | C UOB-HEP 20 12

UNIVERSITY OF BRISTOL
HIGH ENERGY PHYSICS GROUP
TITLE

H.H.WILLS PHYSICS LAB, TYNDALL AVE, BRISTOL, BS8 1TL.
fmc_tlu_v1_lib
MODULE: fmc_tlu_cfd

LICENSED UNDER THE TAPR OPEN HARDWARE LICENSE (WWW.TAPR.ORG/OHL)

TOTAL NO. OF SHEETS

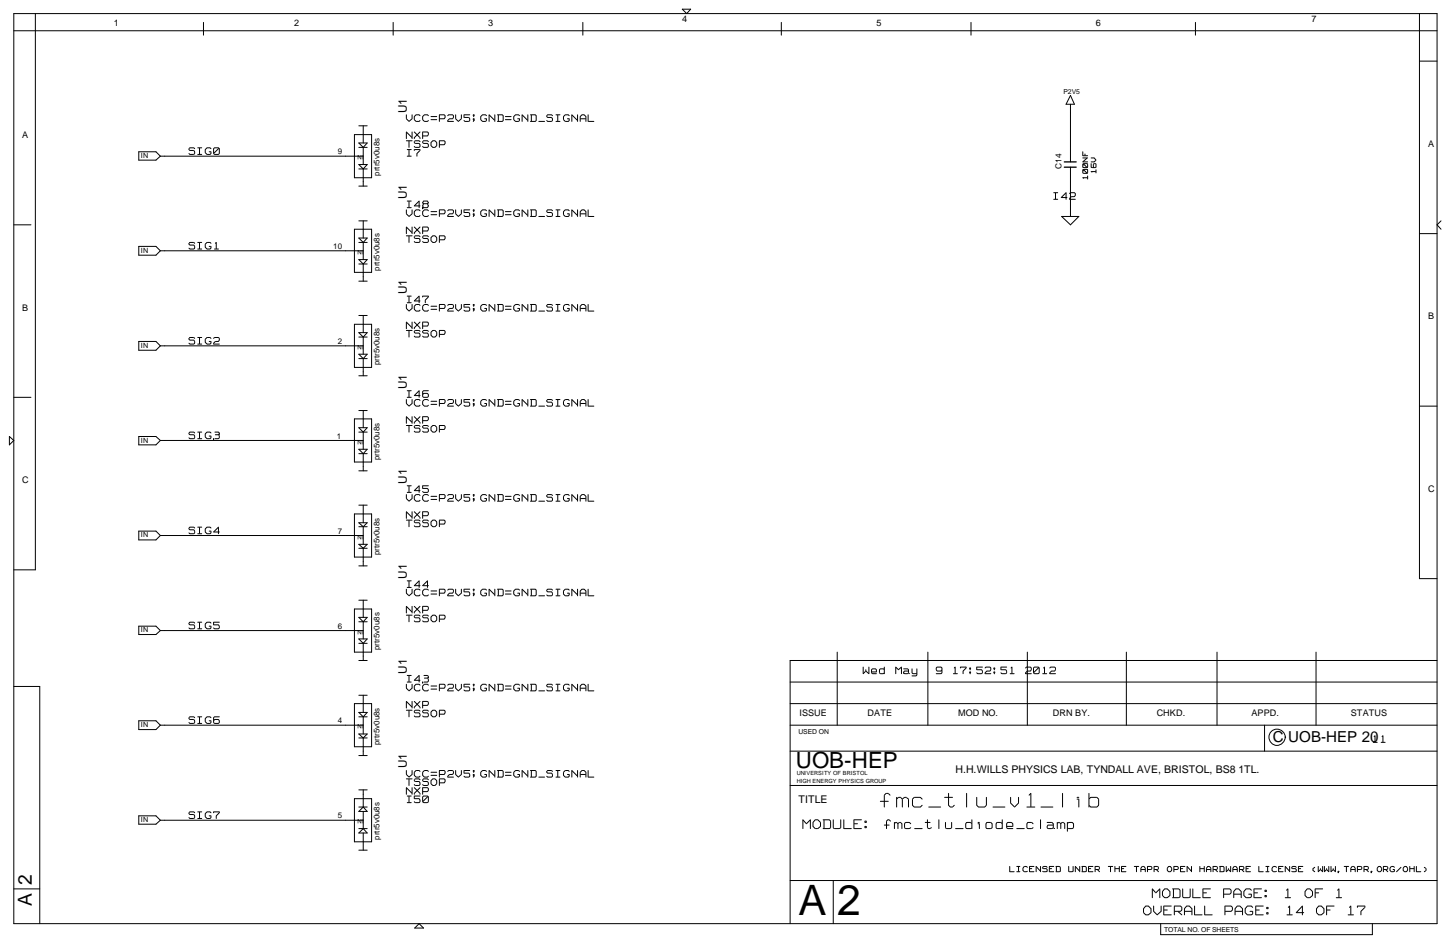
[picture p15: page 8]
Wed May; OVERALL; PAGE: 14; MODULE; PAGE: 1 OF 1; fmc_tlu_v1_lib; VCC=P2V5;GND=GND_SIGNAL; TSSOP NXP; SIG7; 100NFSIG0; NXP TSSOP; TSSOP; NXP; SIG1; SIG2; SIG3; SIG5; SIG6; SIG4; prtr5v0u8s prtr5v0u8s prtr5v0u8s prtr5v0u8s prtr5v0u8s prtr5v0u8s prtr5v0u8s prtr5v0u8s; U1 U1 U1 U1 U1 U1 U1 U1 C UOB-HEP 20; UOB-HEP

ISSUE | DATE | MOD NO. | DRN BY. | CHKD. | APPD. | STATUS
USED ON | 11

UNIVERSITY OF BRISTOL
HIGH ENERGY PHYSICS GROUP
TITLE
MODULE: fmc_tlu_diode_clamp

H.H.WILLS PHYSICS LAB, TYNDALL AVE, BRISTOL, BS8 1TL.

LICENSED UNDER THE TAPR OPEN HARDWARE LICENSE (WWW.TAPR.ORG/OHL)

TOTAL NO. OF SHEETS

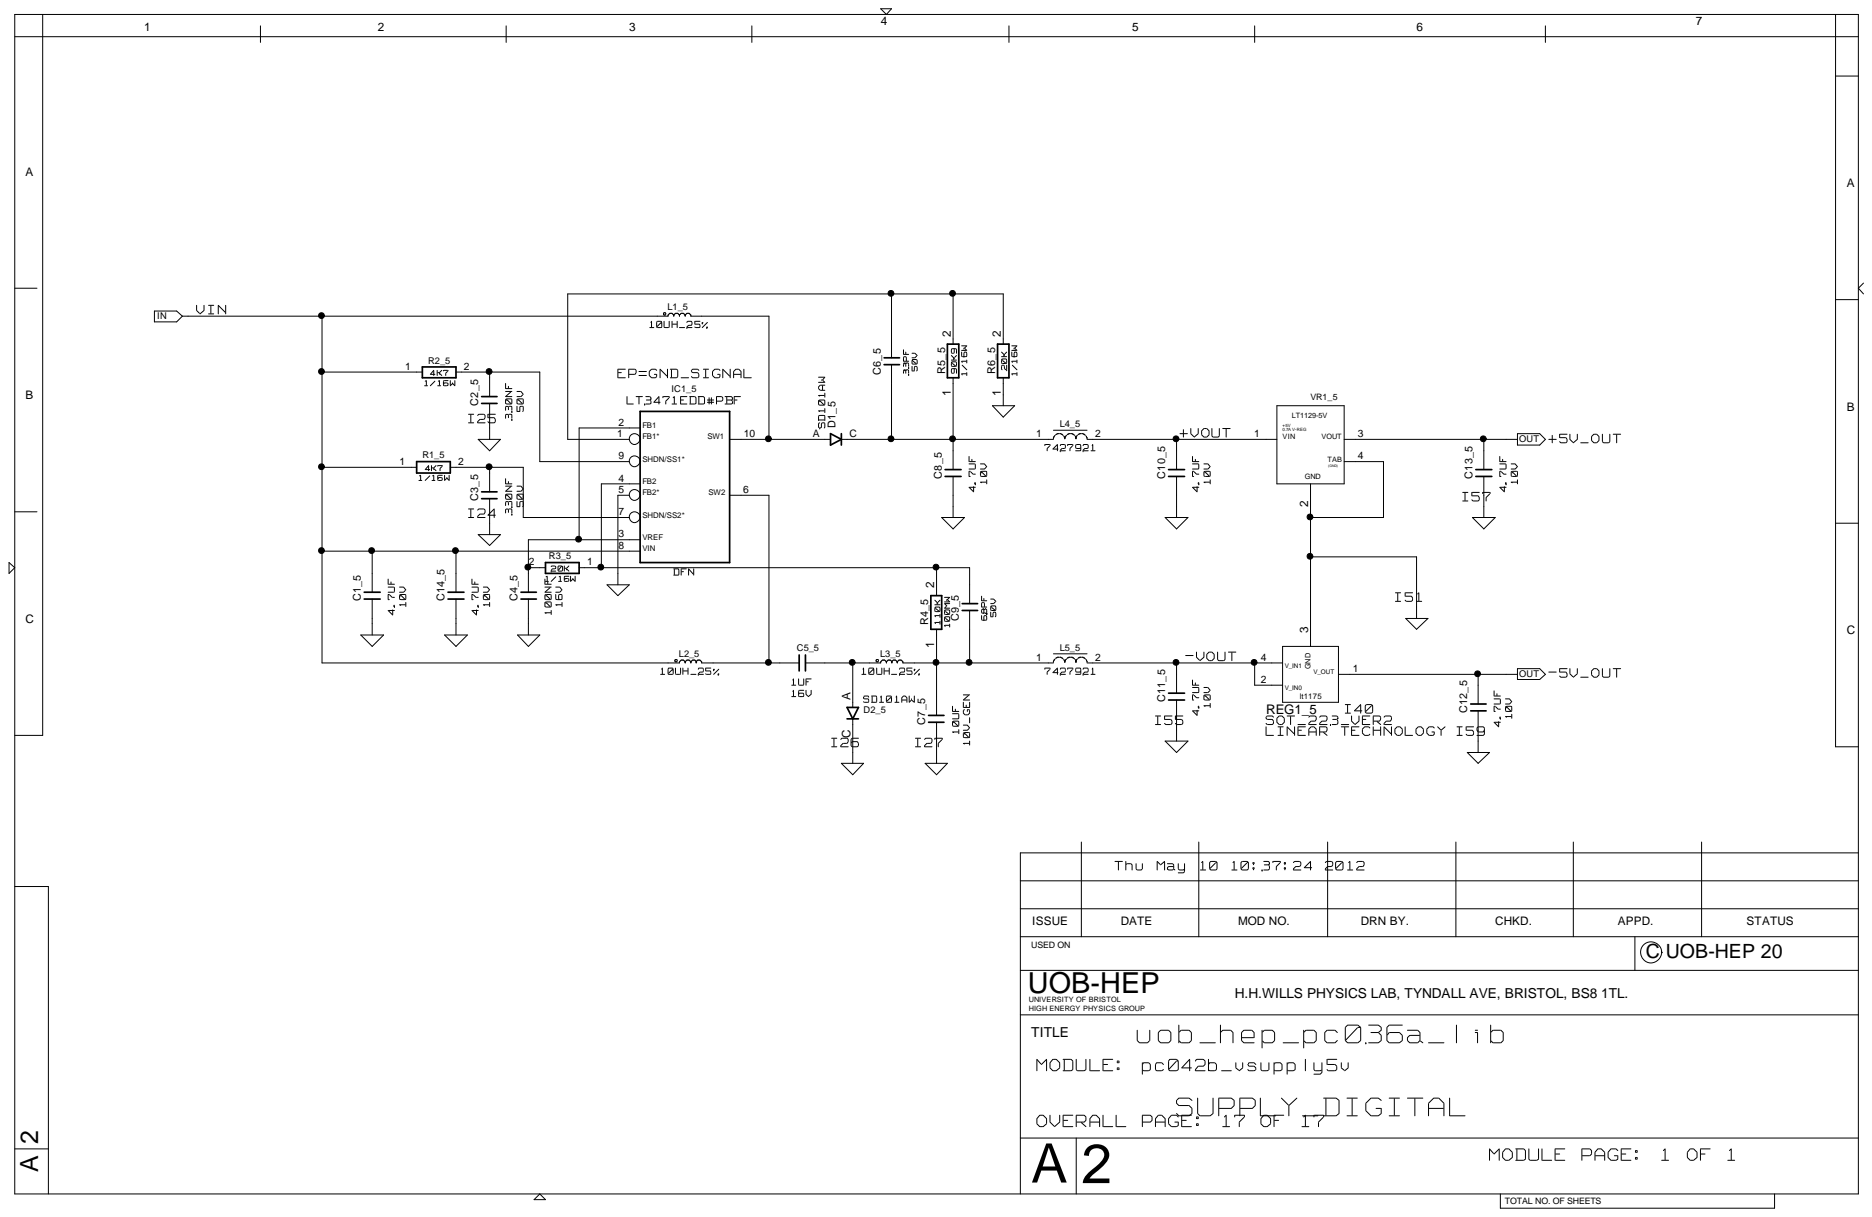
[picture p16: page 9]
SUPPLY_DIGITAL; Thu May 10 10:37:24 2012; OVERALL; PAGE: 17 OF 17; MODULE; PAGE: 1 OF 1; uob_hep_pc036a_lib; MODULE:; pc042b_vsupply5v; -VOUT; +VOUT; EP=GND_SIGNAL; LT3471EDD#PBF; SOT_223_VER2; DFN; +5V_OUT; -5V_OUT; VIN; LINEAR TECHNOLOGY; 10V_GEN16V; (GND); 0.7A V-REG; V_OUT; GND; TAB; VOUT; VREF VIN; SHDN/SS2*; SHDN/SS1*; OUT; REG1_5; UOB-HEP

ISSUE | DATE | MOD NO. | DRN BY. | CHKD. | APPD. | STATUS

USED ON | C UOB-HEP 20

UNIVERSITY OF BRISTOL
HIGH ENERGY PHYSICS GROUP
TITLE

H.H.WILLS PHYSICS LAB, TYNDALL AVE, BRISTOL, BS8 1TL.

TOTAL NO. OF SHEETS
