git-tests/benchmarks/documents/AIDA-logo_cmyk.pdf

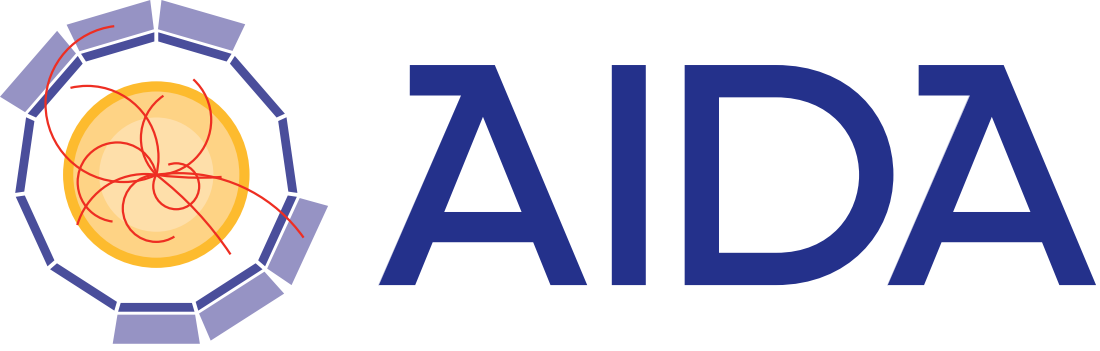
[picture p17: page 1]
