git-tests/benchmarks/documents/diagrams/calice_ccc_tlu.pdf

# CCC

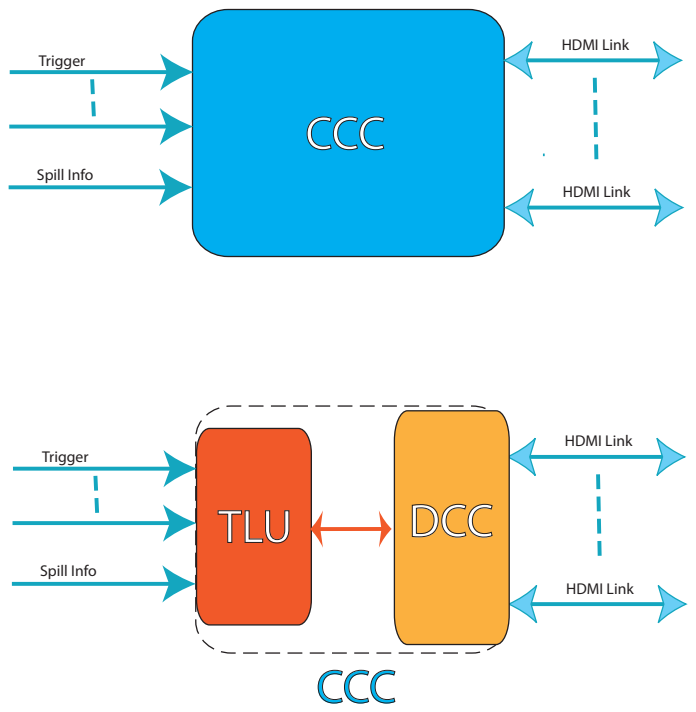
[picture p18: page 1]
HDMI Link; Trigger; Spill Info; CCC; TLU; DCC
