git-tests/benchmarks/documents/diagrams/tlu_ccc.pdf

## DCC

## LDA

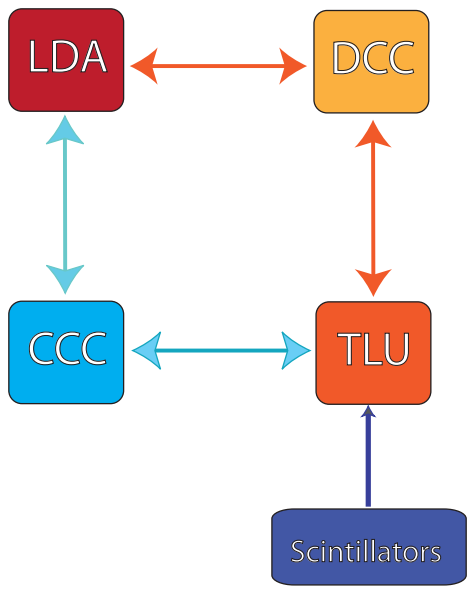
[picture p19: page 1]
CCC; TLU; Scintillators
