git-tests/benchmarks/documents/diagrams/tlu_ccc_bif.pdf

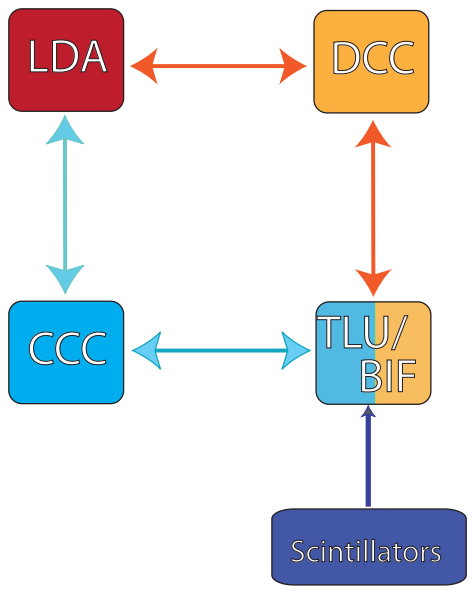
[picture p20: page 1]
DCC; CCC; LDA; TLU/; Scintillators; BIF
