git-tests/benchmarks/circuit_board/Cadence/pc042a_lib/pc042a_toplevel/physical/pc042a_toplevel_09.pdf

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

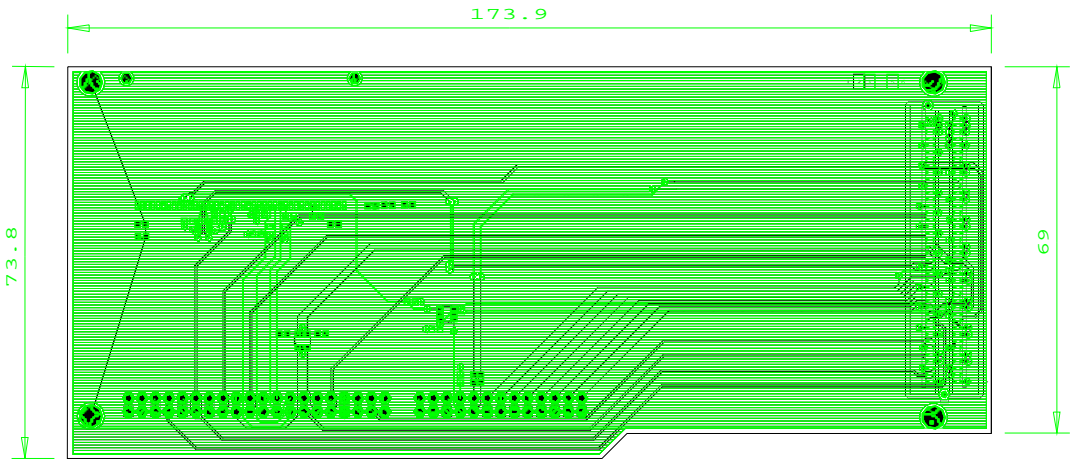
[picture p21: page 1]
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
