git-tests/benchmarks/documents/diagrams/tlu_ccc copy.pdf

## DCC

## LDA

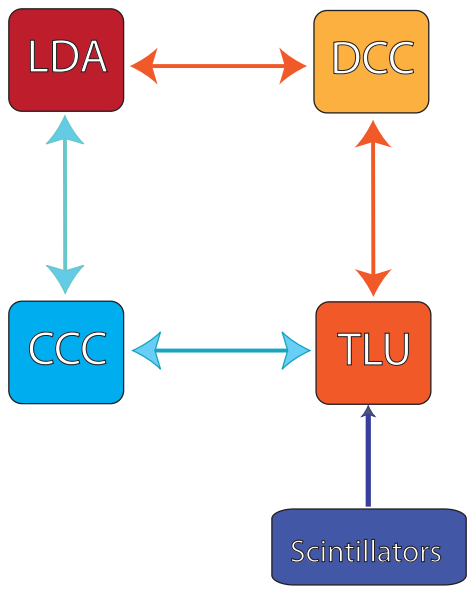
[picture p22: page 1]
CCC; TLU; Scintillators
