git-tests/benchmarks/(list of files, drawings)

Other design files:
circuit_board/Cadence/worklib/pc023a_dac_vthresh/psp_sim_1/pc023a_dac_vthresh.opj
