git-tests/benchmarks/circuit_board/Cadence/pc042a_lib/pc042a_toplevel/physical/art_param.txt

DEVICE-TYPE           GERBER_RS274X
OUTPUT-UNITS          MM
FILM-SIZE             70000000 40000000
FORMAT                5.5
ABORT-ON-ERROR        NO
SCALE                 1
SUPPRESS-LEAD-ZEROES  NO
SUPPRESS-TRAIL-ZEROES NO
SUPPRESS-EQUAL        YES
UNDEF-APT-CONT        NO
