git-tests/benchmarks/(commit log)

2011-02-22 Checking in initial files for Cadence Allegro
    [expand.cfg, page1.csv]
2011-05-05 Checking in working files. Not complete
    [expand.cfg, fmc_tlu_sp601_pad.csv, fmc_tlu_sp601_timesim.sdf, page1.csv, page2.csv, pulse_shaper_pad.csv]
2011-10-04 Checking in Cadence Schematics
    [page1.csv]
2011-12-06 Checking in updated schematics
    [case.cfg, cases.cfg, double_width_FMC_template.brd, expand.cfg, fmc_tlu_01.brd, fmc_tlu_v1_01.brd, fmc_tlu_v1_02.brd, fmc_tlu_v1_03.brd]
2012-03-26 Checking in updated files
    [expand.cfg, page1.csv, page2.csv]
2012-05-04 Checking in updated schematics. Modified with Cadence SPB16.5
    [expand.cfg, page1.csv, page2.csv, page3.csv]
2012-05-04 Swapped threshold discriminators for threshold+CFD discriminator. Created PCB layout module for threshold+CFD discriminator and placed on main board.
    [BSTPLC.brd, cases.cfg, expand.cfg, fmc_tlu_cfd_01.brd, fmc_tlu_cfd_02.brd, fmc_tlu_cfd_03.brd, fmc_tlu_cfd_04.brd, fmc_tlu_cfd_blank.brd]
2012-05-04 Replaced AD5316 + ADR421 ADC and reference with AD5665R ADC with internal reference. Reduces component count.
    [fmc_tlu_v1_06.brd, fmc_tlu_v1_07.brd, page1.csv, page2.csv, page3.csv]
2012-05-11 Work on PCB schematics and layout. - Added test-points to Vthr and PECL outputs on comparators in schematic Modified PCB module and re-placed on top-level PCB - Added 2-signal diode clamps to LVDS si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
    [expand.cfg, fmc_tlu_cfd_05.brd, page1.csv, page2.csv, page3.csv]
2012-05-11 Comitting files omitted from previous revision - - updated toplevel PCB layout ( fmc_tlu_v1_17.brd) - diode-clamp module
    [fmc_tlu_v1_08.brd, fmc_tlu_v1_09.brd, fmc_tlu_v1_10.brd, fmc_tlu_v1_11.brd, fmc_tlu_v1_12.brd, fmc_tlu_v1_13.brd, fmc_tlu_v1_14.brd, fmc_tlu_v1_15.brd]
2012-05-17 * Added 3.3V --> +/-5V DC-DC converter to schematic
    * Copied files from pc042a ( containing DC-DC converter schematic and PCB layout )
    * Re-exported after fixing bug in usblc6 symbol pinout
    * Defined differential pairs in PCB layout and imported to schematic
    * Added switchable 3.3V power to HDMI connectors.
    * Added 24aa025e48 EEPROM with unique ID ( for board ident. )
    [allegro_plot_param.txt, art_param.txt, case.cfg, cases.cfg, expand.cfg, fmc_template.brd, nc_param.txt, page1.csv]
2012-05-18 * Added schematics for constant-fraction discriminator with PECL D-type registers. Might be needed if the FPGA logic can't be made to work with short asynchronous pulses.
    * Added schematics for constant fraction discriminator module and top level FMC-TLU
    * Added latest board layout
    [fmc_tlu_v1_18.brd, fmc_tlu_v1_19.brd, fmc_tlu_v1_20.brd, page1.csv]
2012-05-30 * Added checklist for schematic.
    * Started to connect up signals to FMC
    [fmc_tlu_toplevel_v1_schematic_checklist.xls, fmc_tlu_v1_20.brd, page1.csv]
2012-11-08 Checking in any changes to schematic before adding connector for clock and/or PMT supply board
    [art_param.txt, fmc_mtlu.xls, fmc_mtlu_ bom.csv, nc_param.txt, page1.csv, page2.csv, page3.csv, pc042b_vsupply5v_08.brd]
2012-11-29 Checking in final layout of FMC-TLU and adding some more firmware
    [expand.cfg, fmc_mtlu.xls, fmc_tlu_v1_21.brd, fmc_tlu_v1_22.brd, fmc_tlu_v1_23.brd, fmc_tlu_v1_24.brd, fmc_tlu_v1_25.brd, fmc_tlu_v1_26.brd]
